robbiecape/pi-current-monitor/arduino/ESP32_CurrentSensor/esp32_CurrentSensorMapping.md

gooddecisions/841FE81B431C -> 11 (temp sensor) -> VIP
gooddecisions/441D64F3AA10 -> 12 (temp sensor) -> SALON
gooddecisions/841FE815D490 -> 13 (temp sensor) -> ENGINE
