robbiecape/pi-current-monitor/(commit log)

2025-10-24 Initial commit: Pi Current Monitor project
2025-10-24 Implement ESP32 Sensor Framework with comprehensive features
    Major refactoring to create reusable framework for all ESP32 sensors:
    Framework Features:
    - WiFi management with sticky credentials (only reset if SSID not found)
    - MQTT with progressive retry (10s → 10min) and never auto-reset
    - Local data buffering to SPIFFS (500KB, hourly files, 30-sec intervals)
    - Automatic buffer upload at 50 msgs/sec when reconnected
    - Web status server accessible at http://{device-name}.local
    - mDNS discovery for easy device access
    - Status reporting via MQTT (IP, signal quality, broker, etc.)
    - Configurable device naming with WiFiManager portal
    - LED status indicators (normal, MQTT retry patterns)
    - AWS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
    [ESP32_CurrentSensor.ino, ESPSensorCore.h, config.h]
2025-10-24 Add periodic WiFi signal quality publishing
    - Publish WiFi signal status every 10 seconds
    - Added STATUS_PUBLISH_INTERVAL config (10000ms)
    - New publishWiFiSignal() method for periodic updates
    - Timer-based publishing in update() loop
2025-10-24 Fix UTF-8 character encoding in web interface
    - Add charset='UTF-8' meta tag to HTML head
    - Fixes checkmark (✓) and special character display issues
    - Previously showed as garbled "âœ"" text
    [ESPSensorCore.h]
2025-10-24 Add password protection to WiFi configuration portal
    - Configuration AP now requires password: "Capefamily1"
    - Added CONFIG_PORTAL_PASSWORD constant in config.h
    - Prevents unauthorized access to device configuration
    - WiFi SSID: "ESP32-{device-name}", Password: "Capefamily1"
    [ESPSensorCore.h, config.h]
2025-10-24 Add per-device CT sensor calibration
    Implement MAC-based calibration lookup to handle ADC variations between ESP32 chips.
    Changes:
    - Created CALIBRATION.md with calibration reference and procedures
    - Added calibration table in current sensor code
    - Automatic MAC-based CT_RATIO lookup on boot
    - Documented calibrations:
    - Board 781C3CCB7270: CT_RATIO = 31.0 (8.28A actual, 9.4A before cal)
    - Board 1 (MAC TBD): CT_RATIO = 35.2 (original calibration)
    - Falls back to default (35.2) if MAC not in table
    - Serial output shows which calibration was loaded
    Why needed: ESP32 ADC characteristics vary between chips due to manufacturing
    tolerances, requiring per-device calibration for accurate curren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
    [ESP32_CurrentSensor.ino]
2025-10-24 Fine-tune CT_RATIO calibration for board 781C3CCB7270
    Adjust CT_RATIO from 31.0 to 31.4 based on refined calibration test.
    - Was reading 8.2A, actual was 8.3A
    - Adjusted CT_RATIO: 31.0 → 31.4
    - Updated CALIBRATION.md with calibration history
2025-10-24 Reduce WiFi power to prevent brownout on weak supplies
    - Set WiFi TX power to minimum (8.5dBm) to reduce current draw
    - Helps ESP32 boards with marginal power supplies
    - WiFi range reduced but prevents brownout detector triggers
    - Remove temporary reset code from setup()
    Note: Some ESP32 boards are more sensitive to power issues than others.
    Adding 100µF capacitor across power pins also helps.
    [ESP32_CurrentSensor.ino, ESPSensorCore.h]
2025-10-24 Remove brownout workarounds - restore clean framework code
    After determining the second ESP32 board had a hardware defect causing
    persistent brownout issues, removed temporary debugging code:
    - Removed pre-configuration WiFi bypass code from setup()
    - Re-enabled web server in framework
    - Framework restored to fully-functional state for working boards
    Board 781C3CCB7270 (CT_RATIO 31.4) remains operational with all features.
    [ESPSensorCore.h]
2025-10-25 Add MQTT web config and fix BOOT button reset
    Fixed two critical issues:
    1. Re-enabled web server (was disabled during brownout testing)
    2. Added continuous BOOT button monitoring in update() loop
    3. Added web interface to change MQTT server without losing WiFi
    New features:
    - /config page: Change MQTT broker IP via web interface
    - /save endpoint: Saves new MQTT settings and reconnects
    - Continuous BOOT button check: Works anytime (hold 3 seconds to reset)
    - Better serial feedback when button pressed/released
    This allows changing MQTT server at the cabin without full reset.
    [ESPSensorCore.h]
2025-10-25 Add Quick Links section to web interface
    Added navigation section with:
    - Home button
    - MQTT Settings button
    - Reminder about BOOT button reset
    Makes it easier to navigate without remembering URLs.
    [ESPSensorCore.h]
2025-10-25 Add complete configuration page for WiFi, MQTT, and device name
    Upgraded /config page to allow changing:
    - Device name (for MQTT topics and mDNS)
    - WiFi SSID and password
    - MQTT broker IP
    Features:
    - Optional password field (leave blank to keep existing)
    - Device restarts after saving
    - Shows new mDNS address after restart
    - All settings saved to preferences
    - WiFi credentials updated via WiFi.begin()
    This allows complete reconfiguration without factory reset.
    [ESPSensorCore.h]
